Diavolo-v/ADC-to-CAN-Module/README.md

# ADC-to-CAN-Module
Design of a compact ADC-toCAN measurement module for Formula Student
