Diavolo-v/ADC-to-CAN-Module/adc-to-can-Kicad/adc-to-can.step

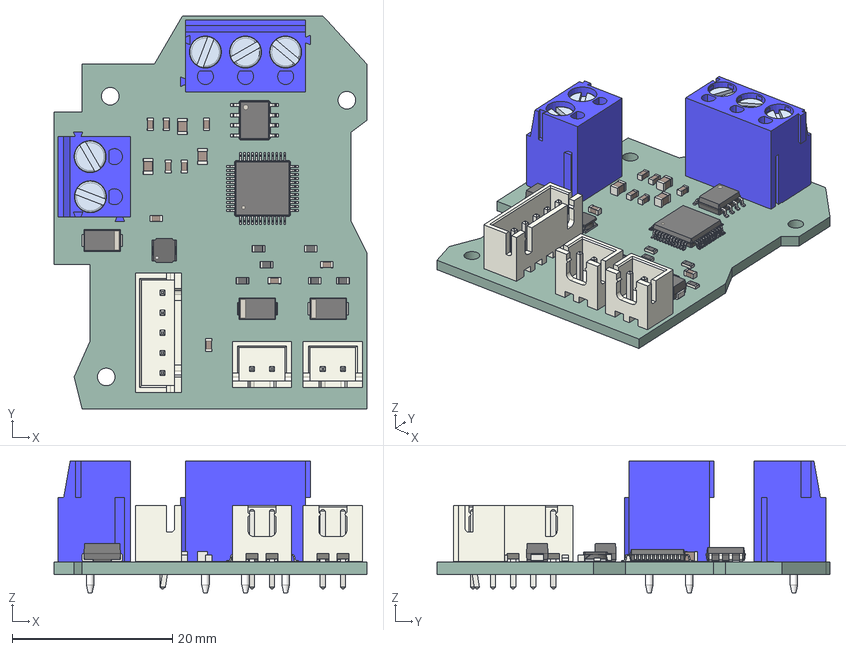
[picture p8: CAD file, 2026-10-31]
adc-to-can-Kicad/adc-to-can.step
39.0 x 49.0 x 16.4 mm
R_0603_1608Metric x 6
JST_B2B_XH_A x 2
Insulator
Wire guard x 5
Screw x 5
Pin x 5
D_SMA x 3
C_0603_1608Metric x 9
Insulator_2
L_Wurth_WE-LQSH-3012
C_0805_2012Metric x 3
JST_B5B_XH_A
LQFP-48_7x7mm_P0.5mm
SOIC-8_3.9x4.9mm_P1.27mm
adc-to-can-unsaved-export-v6IK2h_PCB
