Diavolo-v/ADC-to-CAN-Module/3d_models/691101710002 (rev1).stp

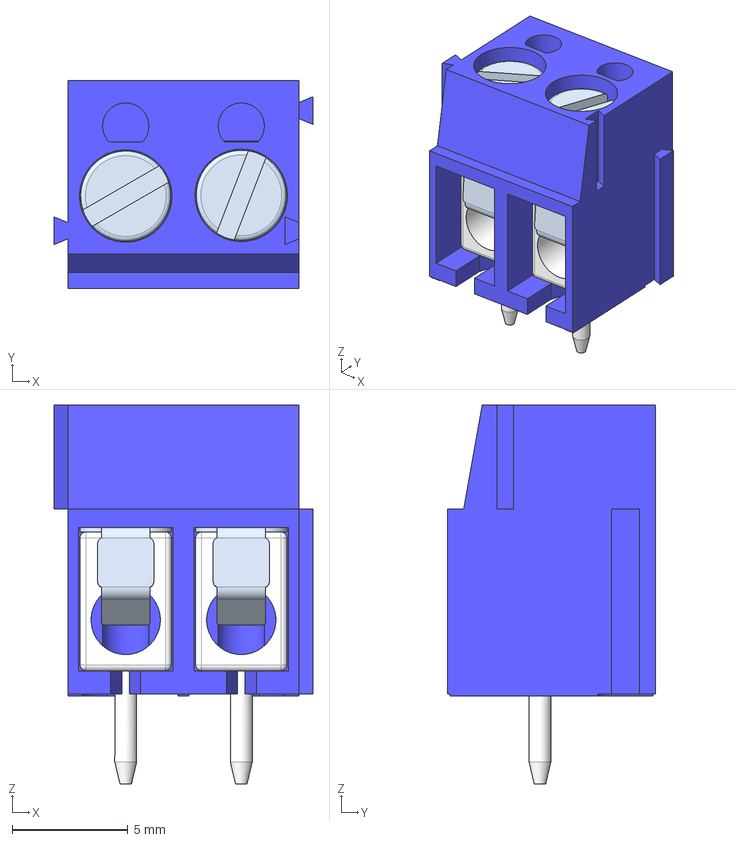
[picture p9: CAD file, 2026-10-31]
3d_models/691101710002 (rev1).stp
11.2 x 9.00 x 16.4 mm
Insulator_2
Wire guard x 2
Screw x 2
Pin x 2
