Diavolo-v/ADC-to-CAN-Module/3d_models/691101710003 (rev1).stp

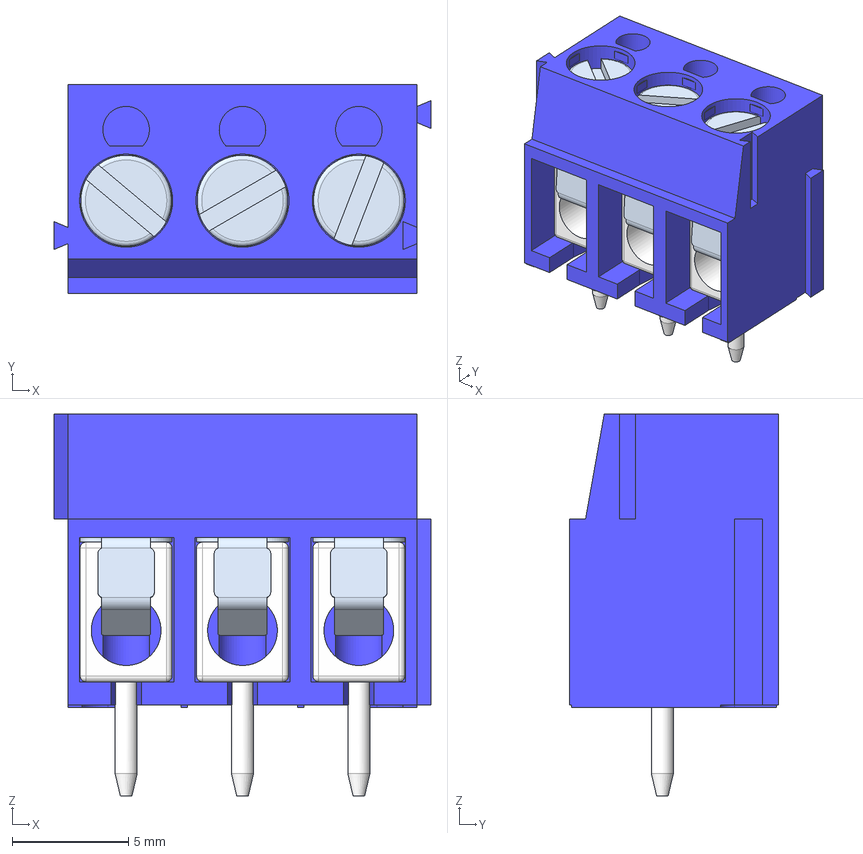
[picture p10: CAD file, 2026-10-31]
3d_models/691101710003 (rev1).stp
16.2 x 9.00 x 16.4 mm
Insulator
Wire guard x 3
Screw x 3
Pin x 3
