Diavolo-v/ADC-to-CAN-Module/adc-to-can-Kicad/adc-to-can.kicad_pcb

## KiCad design adc-to-can-Kicad/adc-to-can.kicad_pcb (2026-10-31)

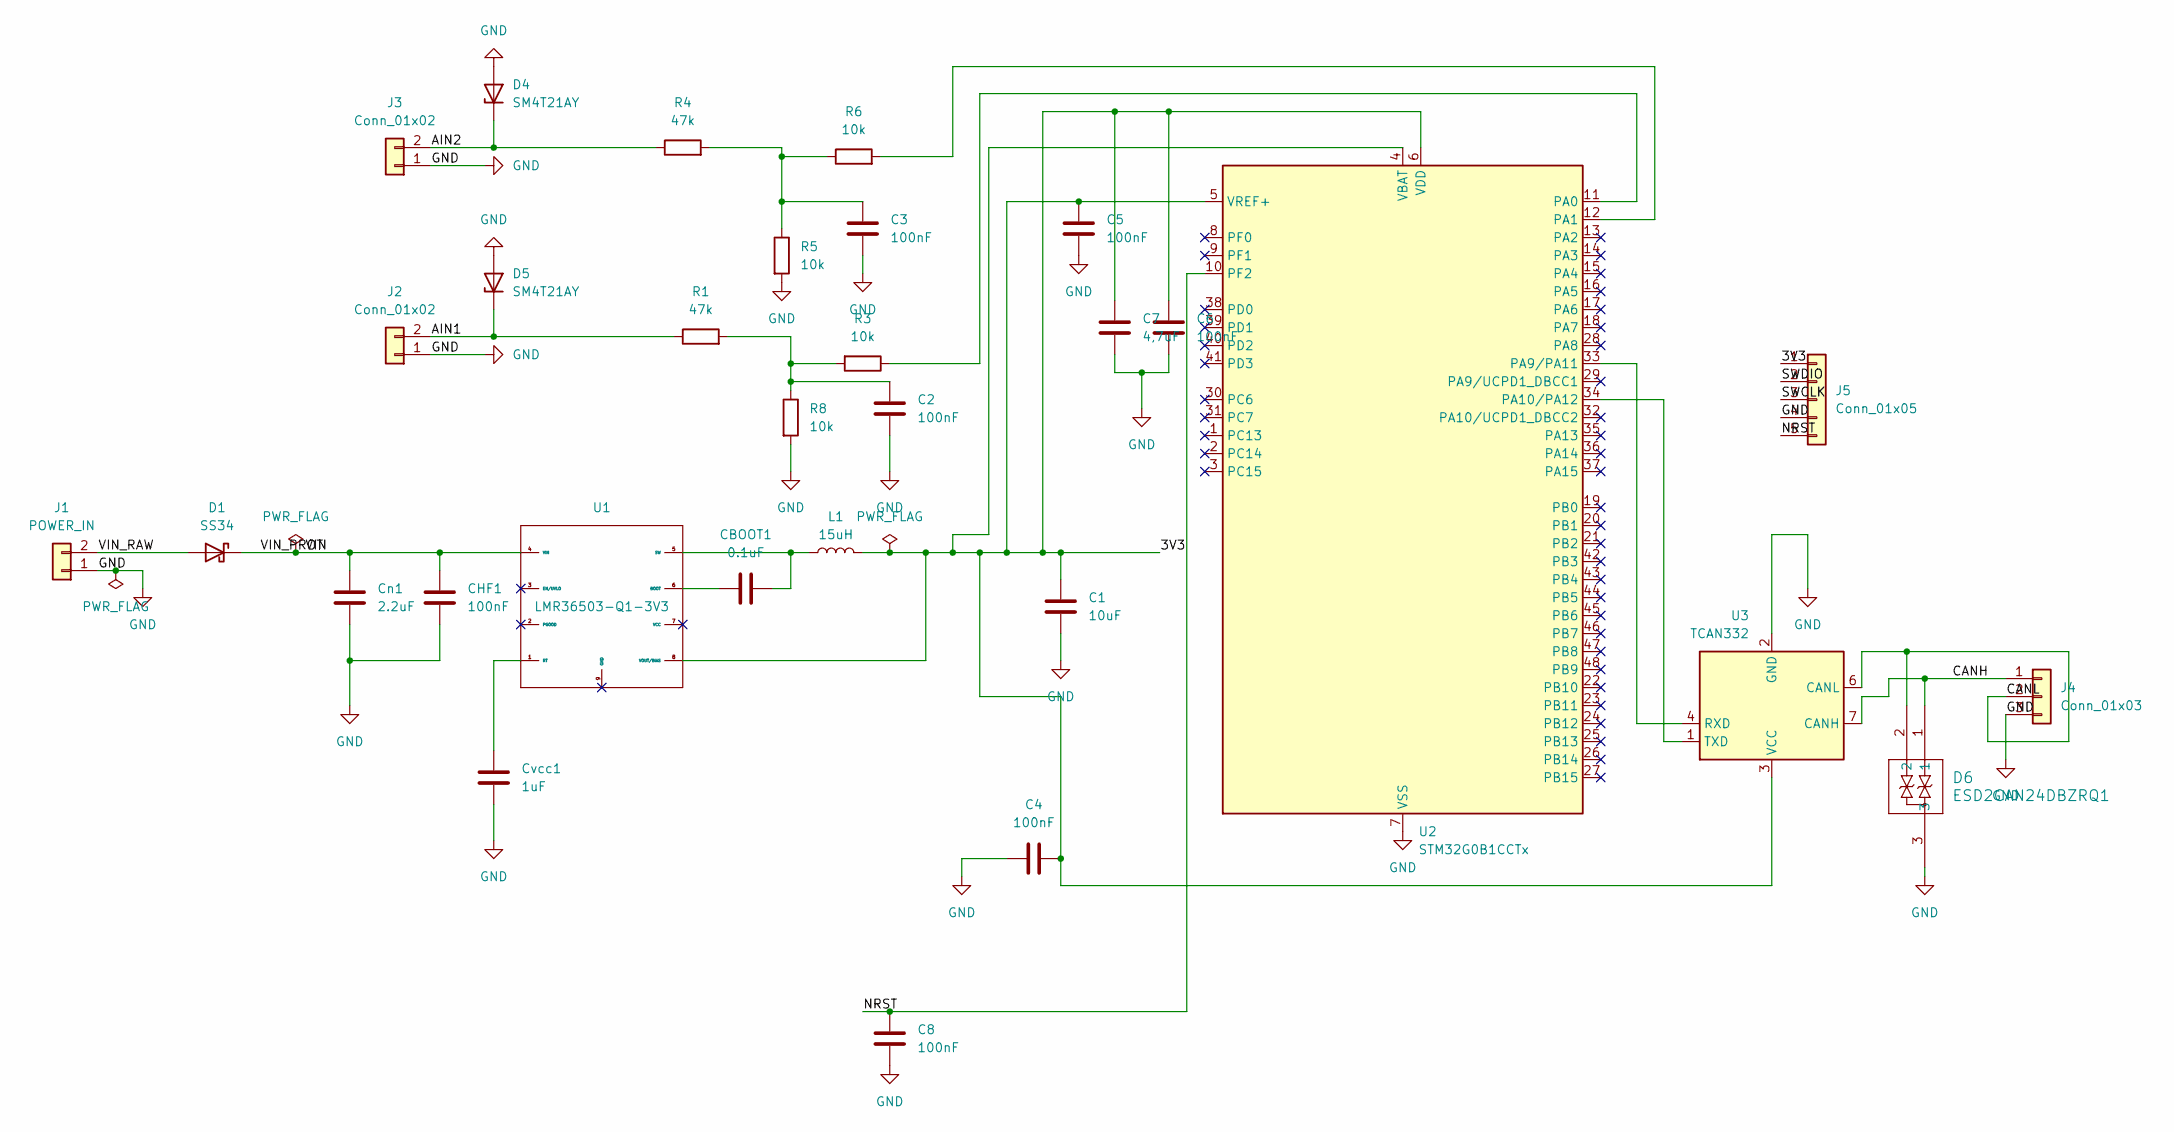
[picture p11: schematic adc-to-can.kicad_sch]

Parts:
C1: 10uF; C_0805_2012Metric
C2, C3, C4, C5, C6, C8: 100nF; C_0603_1608Metric
C7: 4,7uF; C_0805_2012Metric
CBOOT1: 0.1uF; C_0603_1608Metric
CHF1: 100nF; C_0603_1608Metric
Cn1: 2.2uF; C_0805_2012Metric
Cvcc1: 1uF; C_0603_1608Metric
D1: SS34; D_SMA
D4, D5: SM4T21AY; D_SMA
D6: ESD2CAN24DBZRQ1; SOT-23_DBZ_TEX
J1: POWER_IN; CONN2_WR-TBL-SERIES101_691101710002_WRE
J2, J3: Conn_01x02; JST_XH_B2B-XH-A_1x02_P2.50mm_Vertical
J4: Conn_01x03; CONN3x1_691101710003_WRE
J5: Conn_01x05; JST_XH_B5B-XH-A_1x05_P2.50mm_Vertical
L1: 15uH; L_Wurth_WE-LQSH-3012
R1, R4: 47k; R_0603_1608Metric
R3, R5, R6, R8: 10k; R_0603_1608Metric
U1: LMR36503-Q1-3V3; RPE0009A
U2: STM32G0B1CCTx; LQFP-48_7x7mm_P0.5mm
U3: TCAN332; SOIC-8_3.9x4.9mm_P1.27mm

Connections:
/3V3: C1.1, C4.2, C5.1, C6.1, C7.1, J5.1, L1.2, U1.8 (VOUT/BIAS), U2.4 (VBAT), U2.5 (VREF+), U2.6 (VDD), U3.3 (VCC)
/AIN1: D5.1 (K), J2.2, R1.1
/AIN2: D4.1 (K), J3.2, R4.1
/CANH: D6.1, J4.1, U3.7 (CANH)
/NRST: C8.1, J5.5, U2.10 (PF2)
/SWCLK: J5.3
/SWDIO: J5.2
/VIN: CHF1.1, Cn1.1, D1.1 (K), U1.4 (VIN)
/VIN_RAW: D1.2 (A), J1.2
GND: C1.2, C2.2, C3.2, C4.1, C5.2, C6.2, C7.2, C8.2, CHF1.2, Cn1.2, Cvcc1.2, D4.2 (A), D5.2 (A), D6.3, J1.1, J2.1, J3.1, J4.3, J5.4, R5.2, R8.2, U2.7 (VSS), U3.2 (GND)
unnamed: C2.1, R1.2, R3.2, R8.1
unnamed: C3.1, R4.2, R5.1, R6.1
unnamed: D6.2, J4.2, U3.6 (CANL)
unnamed: CBOOT1.1, U1.6 (BOOT)
unnamed: Cvcc1.1, U1.1 (RT)
unnamed: CBOOT1.2, L1.1, U1.5 (SW)
unnamed: R3.1, U2.11 (PA0)
unnamed: R6.2, U2.12 (PA1)
unnamed: U2.33 (PA9/PA11), U3.4 (RXD)
unnamed: U2.34 (PA10/PA12), U3.1 (TXD)

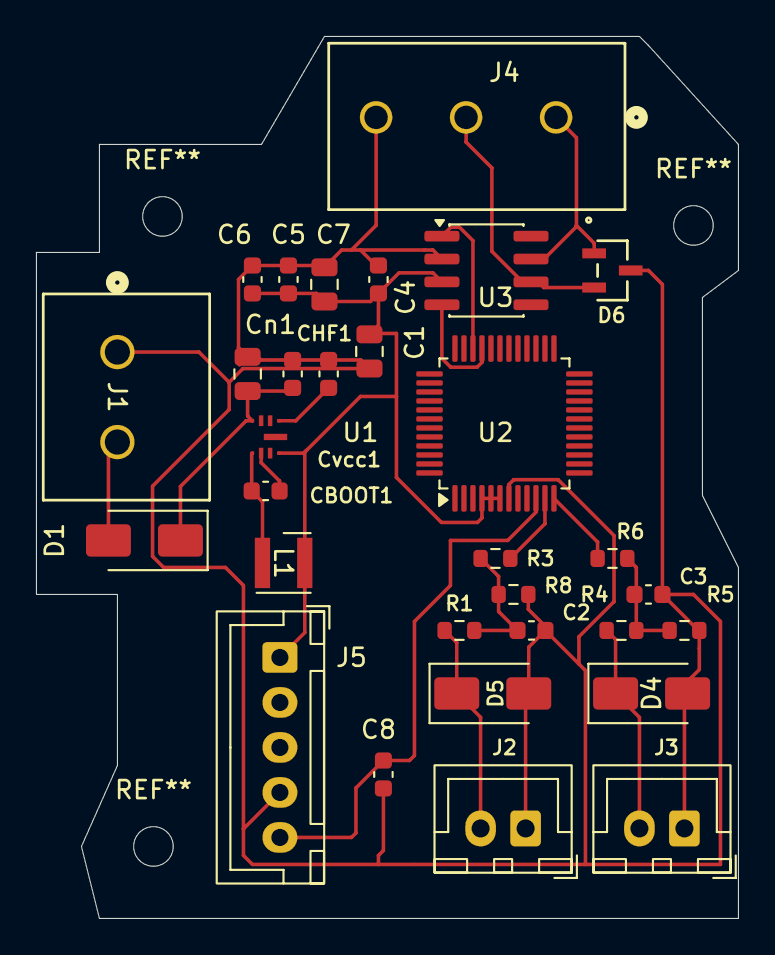
[picture p12: board adc-to-can.kicad_pcb from above]

Board: 2 copper layers, 39.0 x 49.0 mm, 31 parts (0 on the bottom side), 18 nets.
