Diavolo-v/ADC-to-CAN-Module/ADC_CAN_MODULE- Firmware/ADC_CAN_Module.ioc

Mcu.UserName=STM32G0B1CCTx
PA0.Signal=ADC1_IN0
PA1.Signal=ADC1_IN1
