Diavolo-v/ADC-to-CAN-Module/(notices)

Notices in the files:
ADC_CAN_MODULE- Firmware/Core/Src/main.c:
Copyright (c) 2026 STMicroelectronics.
All rights reserved.
This software is licensed under terms that can be found in the LICENSE file
